safa-jsk/Smart-Shopping-Cart/Poster.pdf

# CHALLENGES

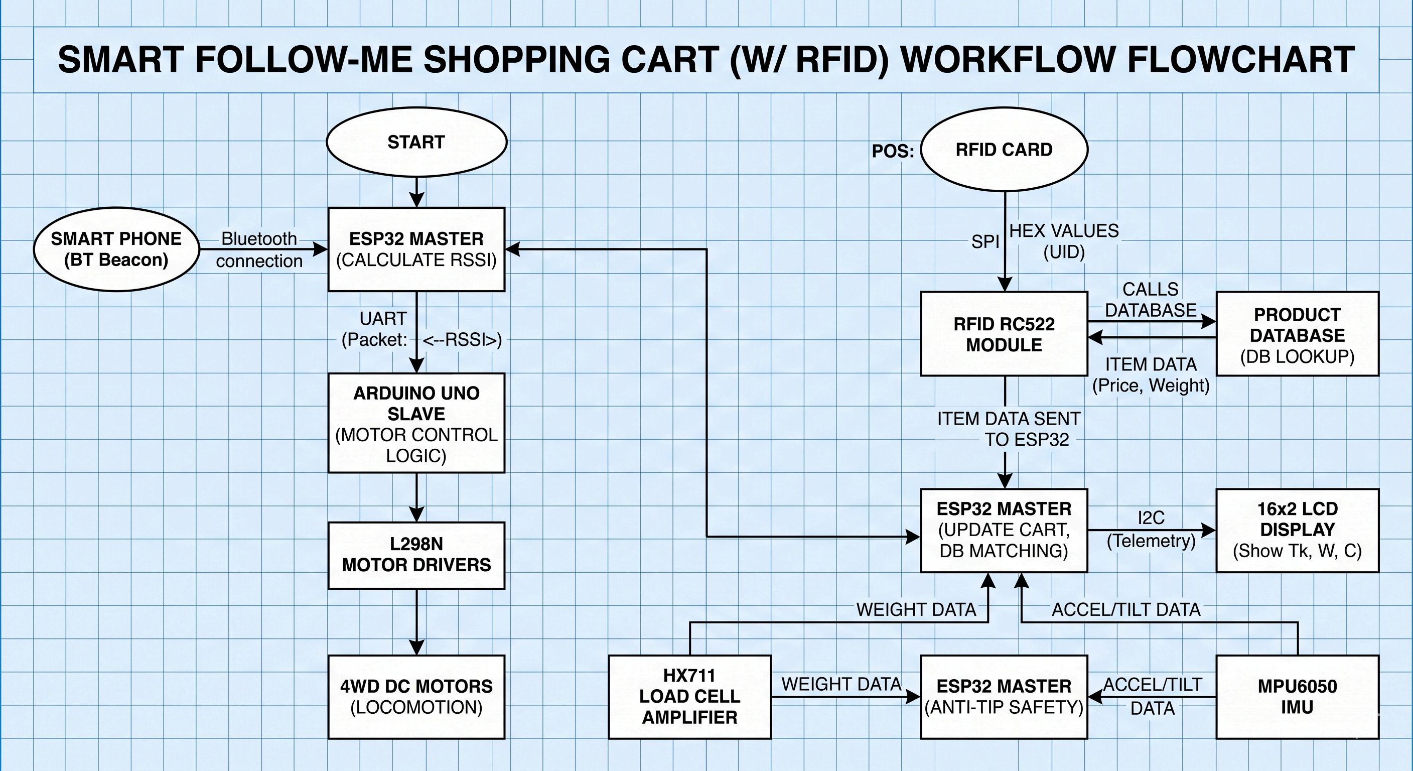
[picture p4: figure]

## I2CPROTOCOLFAILURE — ESP32 & UNOSPEED MISMATCHPREVENTEDSTABLEI2C

COMMUNICATION.E.

## SWITCHEDTOUART WITH

FRAMEDPACKETS(E.G.

<-75>)

## AT 10HZ, WITHA1000MS

DEADMAN'SSWITCHTIMEOUT.

## ULTRASONICGHOSTECHOES — HC-SR04 RETURNEDFALSE"0"READINGS MISREADAS

999CM,CAUSINGABRUPTSTOPS.

## ADDEDASOFTWAREFILTER REJECTINGVALUES ≤ 0CM AND

ABOVETHESAFETHRESHOLD.

## 4WD MOTORSTALLING — REAR WHEELSSTALLEDDUETOPOOR CURRENTDISTRIBUTIONAND WRONG

TB6612FNGPIN MAPPING.

## UPGRADEDTODUAL L298N

DRIVERS(ONEPERSIDE),

## REFACTOREDTOHARDWAREPWM PINSD5/D9,SYNCHRONIZEDIN

PINS.

PROBLEMS | RESOLUTIONS

# RESULTS/FINDINGS

# ABSTRACT

This project develops a self-directed Auto-Following Shopping Cart with an integrated RFID self-checkout system. Designed to ease retail experiences, it eliminates the burden of pulling carts and reduces checkout time. The system uses a dual-microcontroller setup (Arduino UNO R3 and ESP32), following users via Bluetooth RSSI, avoiding obstacles with ultrasonic sensors, and stabilizing movement through an MPU6050 IMU. Two RFID RC522 readers and HX711 load cells allow item scanning and real-time monitoring of cost and weight on an LCD display. The prototype demonstrates a low-cost, effective solution for small retail settings, enhancing accessibility for elderly and physically impaired shoppers while also serving as a simple budgeting tool for everyday users.

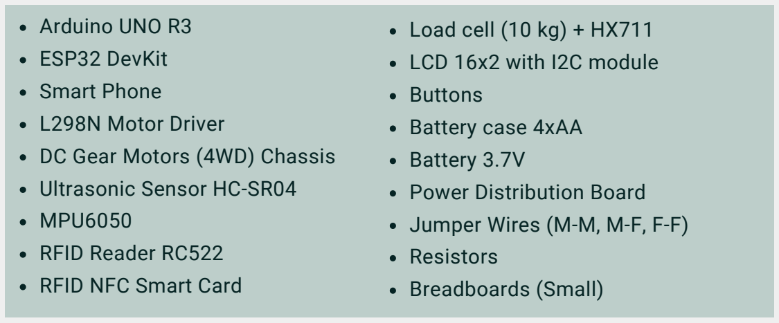
[picture p5: figure]
Arduino UNO R3 ESP32 DevKit Smart Phone L298N Motor Driver DC Gear Motors (4WD) Chassis Ultrasonic Sensor HC‑SR04 MPU6050 RFID Reader RC522 RFID NFC Smart Card; Load cell (10 kg) + HX711 LCD 16x2 with I2C module Buttons Battery case 4xAA Battery 3.7V Power Distribution Board Jumper Wires (M-M, M-F, F-F) Resistors Breadboards (Small)

BLUEPRINT | CIRCUIT INTEGRATION

# FUNCTIONALITY WORKFLOW

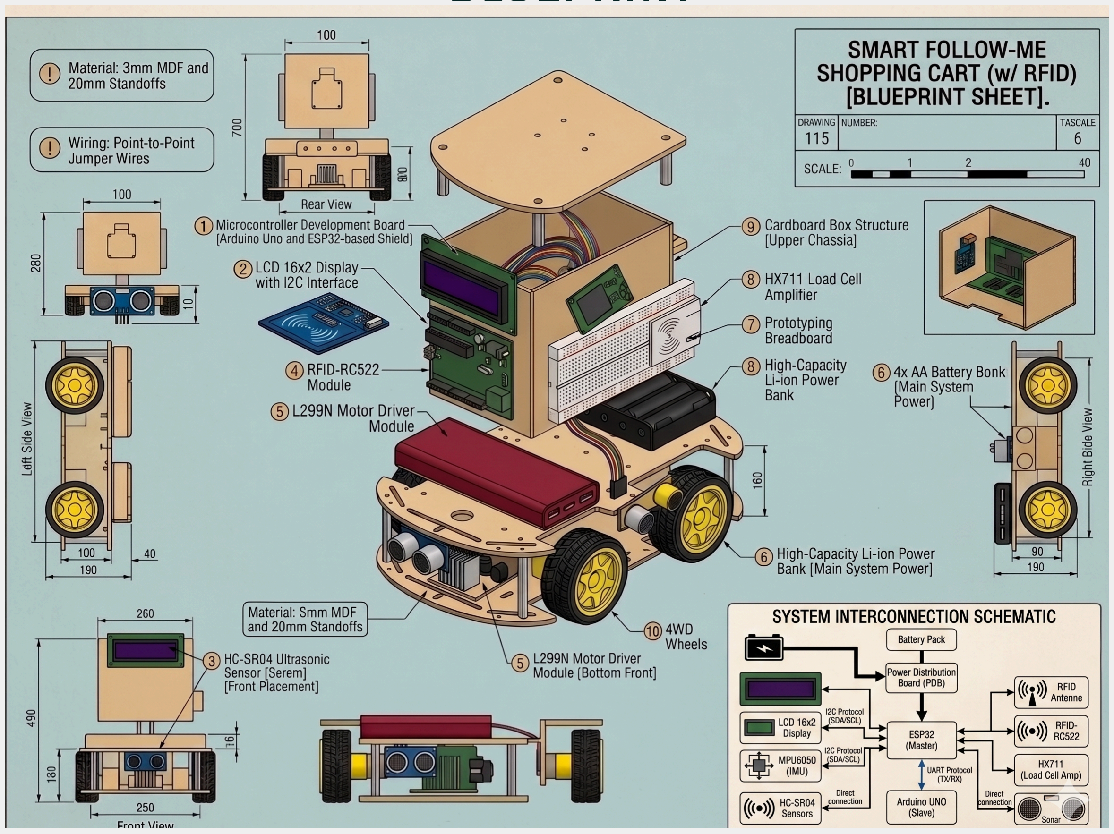
[picture p6: figure]
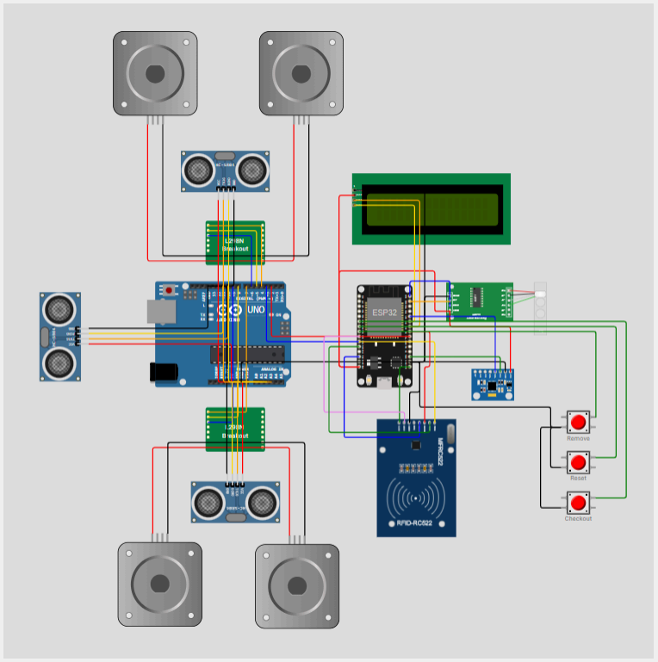
[picture p7: figure]

# RFID & POS: 100% SCANACCURACY.ANTI-THEFT IMPLEMENTATION WASNOTPOSSIBLE DUE TOLOADCELLDRIFT.ALLBUTTONS

FUNCTIONAL.

# SMARTAUTO-FOLLOWINGSHOPPINGCART

# (W/RFID)

# AUTHORS

### Fariha Tanha Mohammad Jabir Safa Khandoker Aarya Ibteda Foyez Mugdha Farheen Kibria Safwan Masud

# CONCLUSION

The Smart Follow-Me Shopping Cart is a highly cost-effective (4,900 BDT) autonomous prototype that uses IoT and sensor fusion to safely follow users, avoid obstacles, and process self-checkouts via RFID. Despite minor sensitivities to signal noise and vibration, it stands as a highly viable proof-of-concept with immense potential to eliminate retail queues and improve accessibility for disabled shoppers.

# COMPONENTSLIST

# OBSTACLEAVOIDANCE: INSTANTSTOPSLESS THAN30CM,SIDESTEERINGLESSTHAN20

CM,FALSEECHOESDISREGARDED.

# SAFETY: IMULOCKED WHEELS35O TILTDEADMANSWITCHCUT MOTORS

ONLOSSOFSIGNAL 1000MS.

# TOTALCOST:4900TAKA

# TRACKING: THEUSERFOLLOWINGIN -50TO-85DBM RSSI ISRELIABLE ANDTHESIGNALNOISEISFILTERED

USINGSOFTWARE.

### CSE461 Spring 2026 Sec:03 Group: 06 Faculty: RDW, SMYA
